newtonis/Assistance-Bracelet/altium/PCB/Electrónica 4 – TP 2 – Grupo 1.pdf

# Instituto Tecnológico de Buenos Aires

## 22.14 - Electrónica IV

# Trabajo práctico N◦2

### Grupo 1

Mechoulam, Alan | 58438
Lambertucci, Guido Enrique | 58009

### Londero Bonaparte, Tomás Guillermo 58150

### Profesores Aguirre, Miguel Pablo Cossutta, Pablo Martín Weill, María Alejandra Salvati, Matías Damián

### Presentado: 22/06/21

22.14 - Electrónica IV | Mechoulam, Lambertucci, Londero

## Índice

1. Parte I | 2
2. Parte II | 2
3. Parte III | 8
4. Parte IV | 15
5. Conclusiones | 18

## 1. Parte I

### 1.1. SG3525A

### 1.1.1. Debajo de la tensión de operación

Este dispositivo cuenta con un pin de control llamado “Shutdown”. Este pin controla tanto el circuito de Soft-Start como las etapas de salida, apagando la salida automáticamente a través de pulsos de shutdown.
Al haber una tensión inferior al mínimo (8 V ) en la entrada, este sistema de shutdown se activa, inhabilitando las salidas y los cambios en el capacitor de Soft-Start.
Esto protege al circuito conectado a la salida de la flyback, asumiendo que es mejor cortar la alimentación que proveer un valor indeterminado de tensión.

### 1.1.2. Señal a la salida

Para seleccionar la frecuencia de la señal a la salida del integrado, se deben conectar dos resistencias y un capacitor en los pines CT y RT . El criterio de selección viene dado por las siguientes limitaciones:

fs =

1
CT (0.7RT + 3RD)

(1)

2.0 kΩ 6 RT 6 150 kΩ
0 Ω 6 RD 6 550 Ω
1 nf 6 CT 6 200 nf

Existe una relación entre la frecuencia del oscilador y la de salida. Sucede que la frecuencia del oscilador es el doble que la frecuencia de salida, dado que en un ciclo acciona una salida y en el siguiente la otra.

Para conseguir una frecuencia de 100 kHz a la salida (∼ 200 kHz en el oscilador), basta con tomar:

RT = 2.2 kΩ
RD = 0 Ω
CT = 3.3 nf

(2)

Para conseguir un Duty deseado, lo que se debe hacer es colocar la salida del amplificador de error a 0 V (pin no inversor a masa y pin inversor a Vref ), luego aplicando una tensión en el pin de compensación (9), es posible manejar el duty de salida.

### 1.1.3. Soft-Start

El pin de Soft-Start cumple con la función de limitar el duty cicle en el arranque, hasta que el capacitor de SS esté cargado. Cuando se está empleando una fuente realimentada se busca que en el arranque no se produzca un duty cycle tal que se llegue a la tensión deseada, sino a una menor hasta que se cargue el capacitor SS. De esta forma se evita que se sobredimensione y se pase del valor que se necesita, disminuyendo así las oscilaciones iniciales.

### 1.1.4. Shutdown

Es posible implementar un circuito limitador de corriente utilizando el pin de Shutdown con una resistencia de shunt y un BJT. Se coloca la resistencia de shunt en el camino de la corriente a sensar y en paralelo a la juntura base emisor del bipolar, y se calcula la resistencia de manera tal que cuando haya una corriente mayor a la permitida, la caída de potencial en la resistencia sea mayor que la tensión necesaria para polarizar la juntura del transistor, el cual en consecuencia coloca una señal alta en el pin de shutdown.

## 2. Parte II

### 2.1. Diseño del sistema

En el sistema que se busca desarrollar, se emplean los siguientes valores para la fuente Flyback:

D = 0.3

L1 = 40 µH

R1 = R3 = 10 Ω

C1 = C3 = 47 µF

C2 = C4 = 2 µF

N1
N2

= 3

N2 = N3

Para el circuito del SG3525 se adoptaron los siguientes valores

RT = 2.2 kΩ

CT = 3.3 nF

RD = 0 Ω

Css = 1 µF

calculando el ripple a la salida se obtiene

0.05 =

∆Vo
Vo

=

DTs
RoC

(3)

C =

DTsVo
RoC∆Vo
= 8.8µF | (4)

por lo que se seleccionó una combinación de capacitores con una capacitancia total de ≈ 48µF siendo el paralelo de 1 capacitor electrolítico,3 cerámicos (2 de 1µF y uno de 68pF). Esta combinación se realiza con la intención de no solo aumentar la capacidad de salida, sino que tambien reducir la ESR neta de salida.
La combinación de valores de RT y CT fueron elegidas para mantener la frecuencia de switching elegida. La resistencia RD es nula para que se descargue lo mas rápido posible. Por último, el capacitor Css es para que tenga un comienzo suave. Para la salida se utilizarón los diodos MUR160 y para el snubber se utilizó el diodo Schottky.
N2 | C1 | C2 | R1
N3 | C3 | C4 | R3

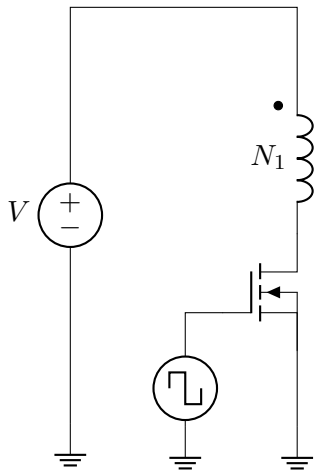
[picture p1: figure]

Figura 1: Circuito del snubber empleado.

### 2.2. Simulaciones

Se simuló el circuito a lazo abierto. De esta forma se obtuvieron las siguientes curvas.

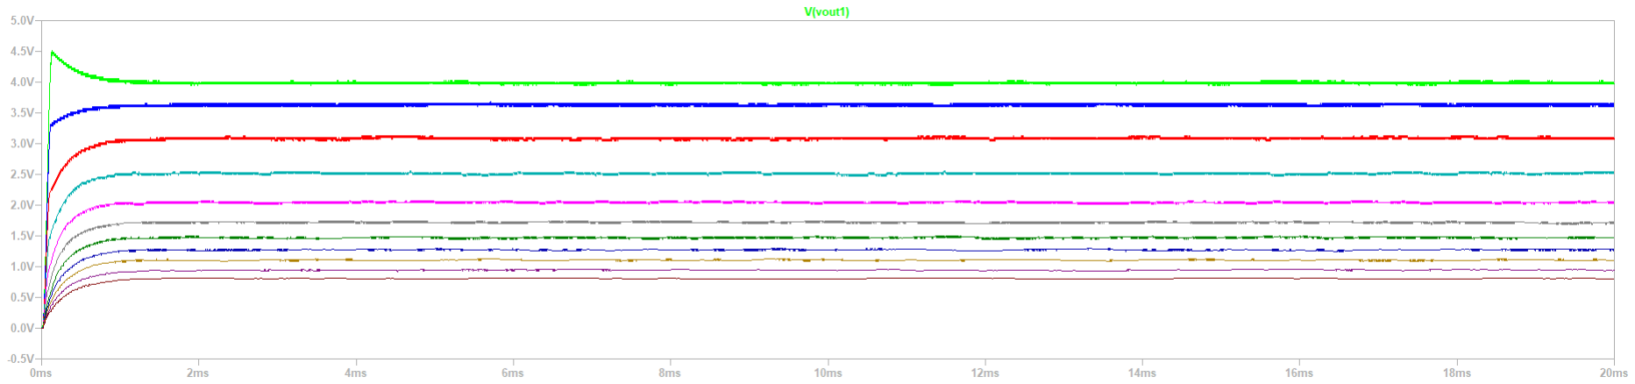
[picture p2: figure]

Figura 2: Variaciones en la Vout al cambiar la Vcomp.

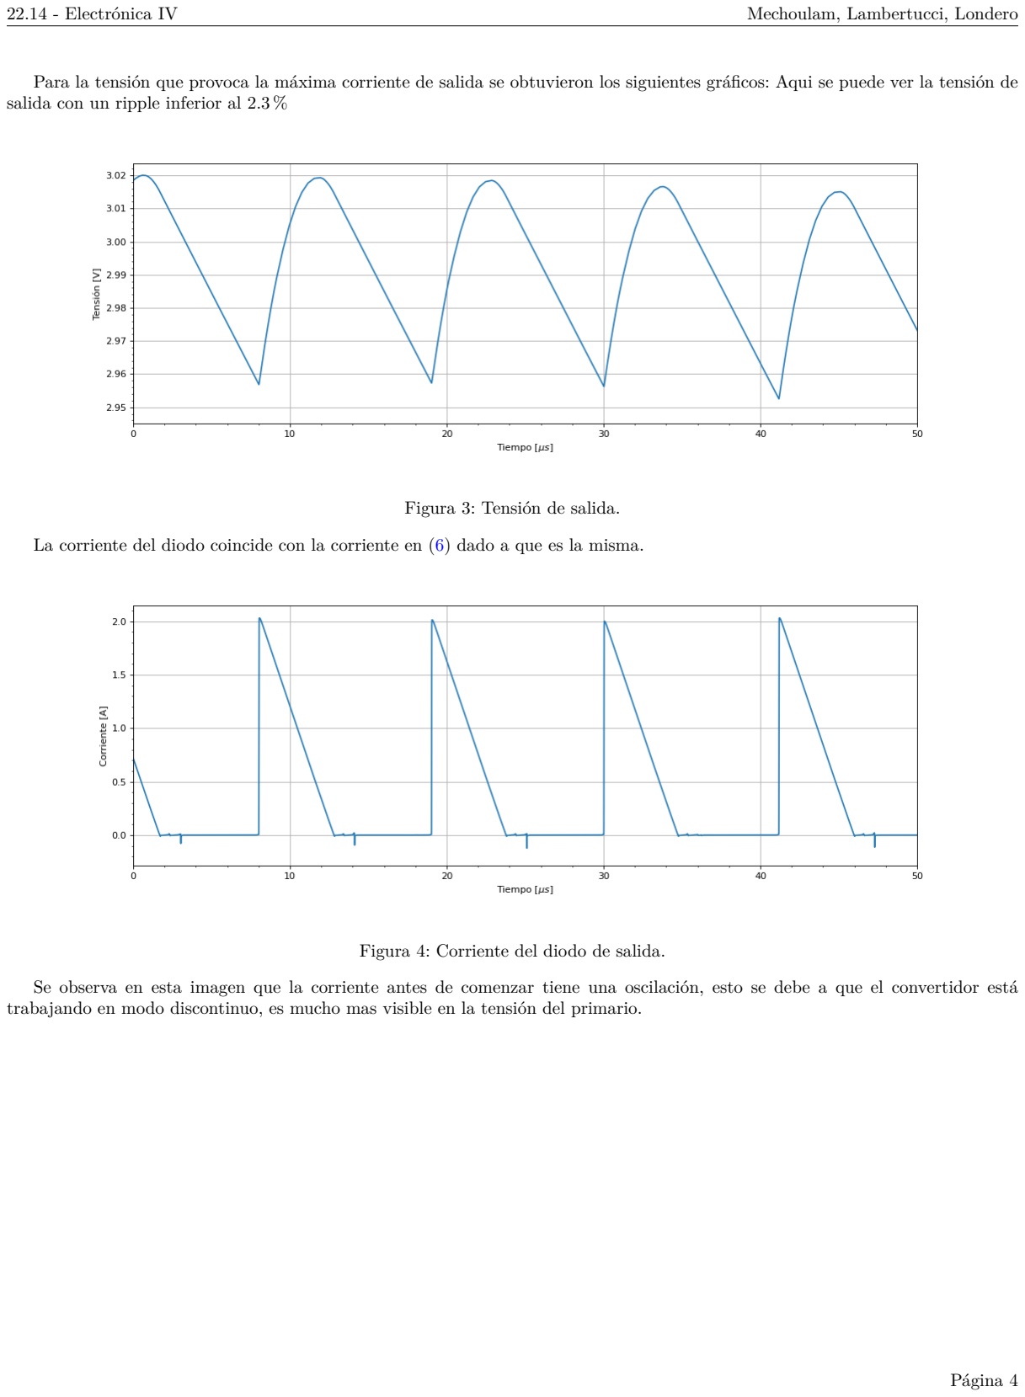
[picture p3: page 5]

Para la tensión que provoca la máxima corriente de salida se obtuvieron los siguientes gráficos: Aqui se puede ver la tensión de salida con un ripple inferior al 2.3 %

Figura 3: Tensión de salida.

La corriente del diodo coincide con la corriente en (6) dado a que es la misma.

Figura 4: Corriente del diodo de salida.

Se observa en esta imagen que la corriente antes de comenzar tiene una oscilación, esto se debe a que el convertidor está trabajando en modo discontinuo, es mucho mas visible en la tensión del primario.

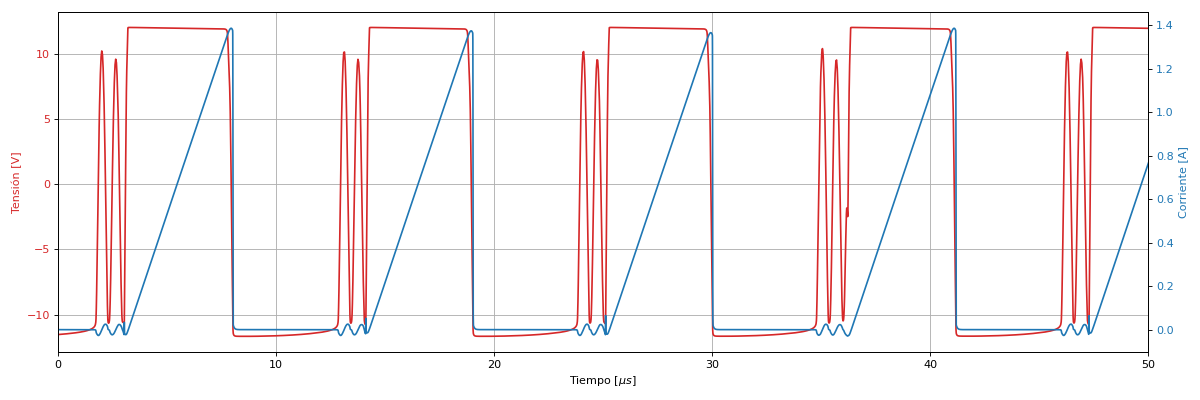
[picture p4: figure]

Figura 5: Tensión y corriente del primario.

Aqui se ve como la oscilación se ve reflejada en el secundario

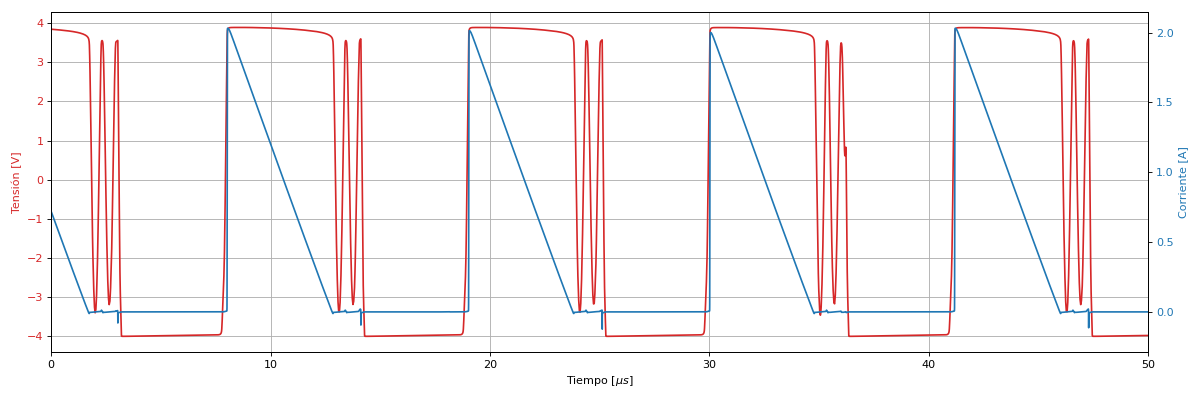
[picture p5: figure]

Figura 6: Tensión y corriente del secundario.

Aqui se ve la tensión de compensación del SG3525.

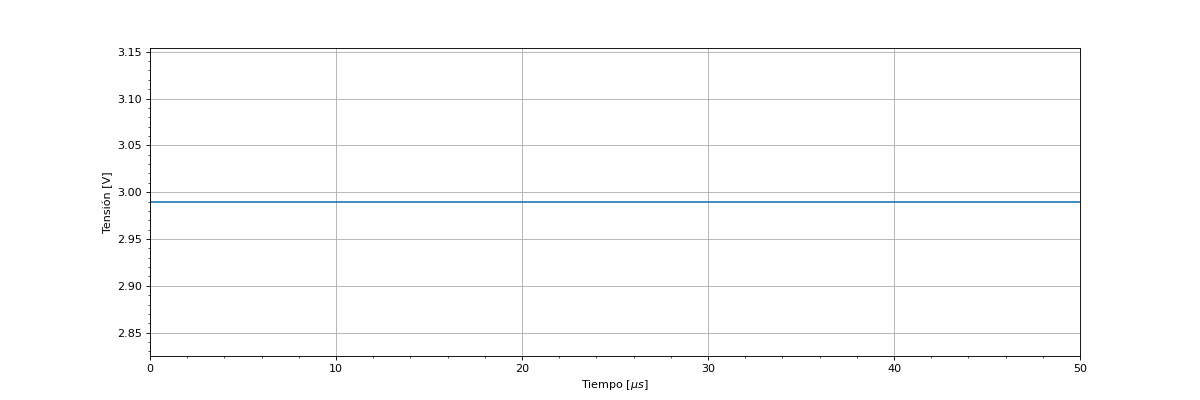
[picture p6: figure]

Figura 7: Tensión de compensación.

En esta imagen se pueden observar varias señales, la verde es la tensión del oscilador del SG3525, la cual cada 2 conmutaciones se traduce a una conmutación en la señal de control del MOS (dado que este cuenta con 2 salidas, en uno actualiza una y en el otro ciclo la otra), por lo que se puede ver como cada 2 pulsos conmuta la Vgs.
Viendo la forma de onda de Vds se aparecia facilmente que el convertidor trabaja en modo discontinuo Idealmente serían 3 niveles de tensión, Vd mas la reflejada, Vd y 0, pero al quedarse sin energía el nucleo, el circuito comienza a oscilar de una manera característica del modo discontinuo.

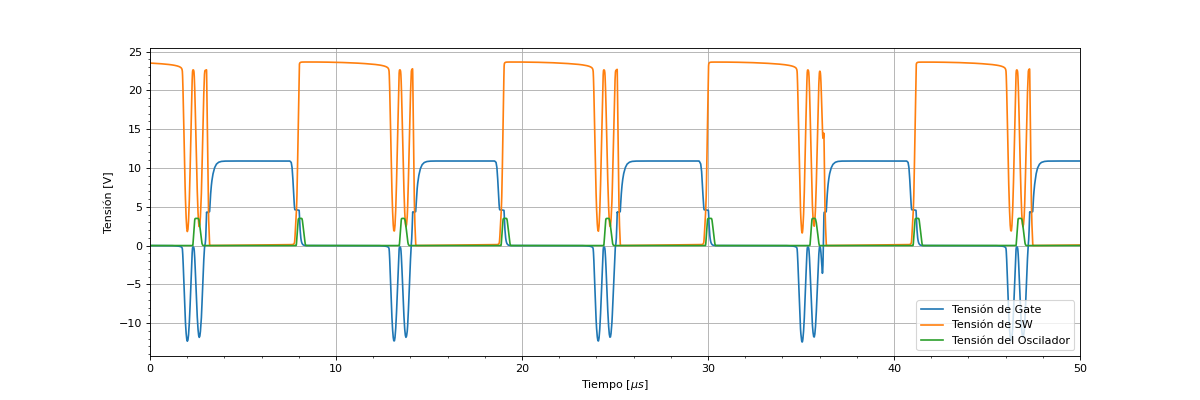
[picture p7: figure]

Figura 8: Tensión de Gate y del Switch.

### 2.3. Snubber

Para el circuito dado, se diseña un snubber empleando un diodo, una resistencia y un capacitor.

Figura 9: Circuito del snubber empleado.

Se calcula el valor máximo del capacitor, planteando que la energía entregada por la inductancia de dispersión debe ser absorbida completamente por el capacitor del snubber. De esta forma, se llega a la expresión:

C > Ld

IL1

2

VC

2 −

VCC − Vo

N1
N2

2 = 1 µH ·

15 A
100 V

2 − (12 V − 3 · 0.8 V )

2 = 23 nF | (5)

De esta forma, se selecciona C = 35 nF. Planteando que tres veces el tiempo característico del sistema RC debe ser menor al tiempo en que el transistor se encuentra encendido, para así descargar completamente al capacitor, se obtiene una restricción similar para la resistencia. Operando, se llega a:

R < DTS
3C
C=10 nF

=

0.3
100 kHz ·

1
3 · 35 nF
= 29 Ω | (6)

Finalmente se selecciona R = 47 Ω.
Para el diodo del snubber se utilizó el diodo schottky 1N5819

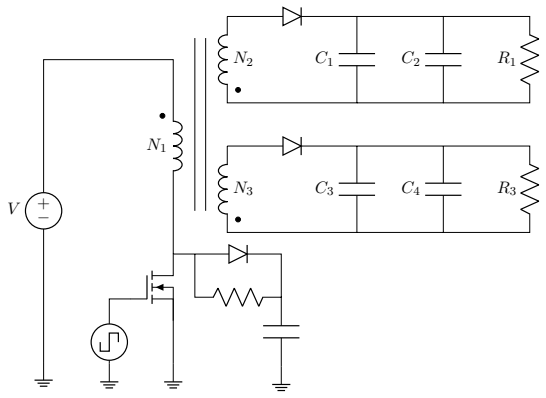
[picture p8: figure]

Figura 10: Circuito Flyback con snubber.

Se simuló el circuito con la integración del snubber y se observa como las oscilaciones provocadas por el modo discontinuo fueron severamente reducidas.

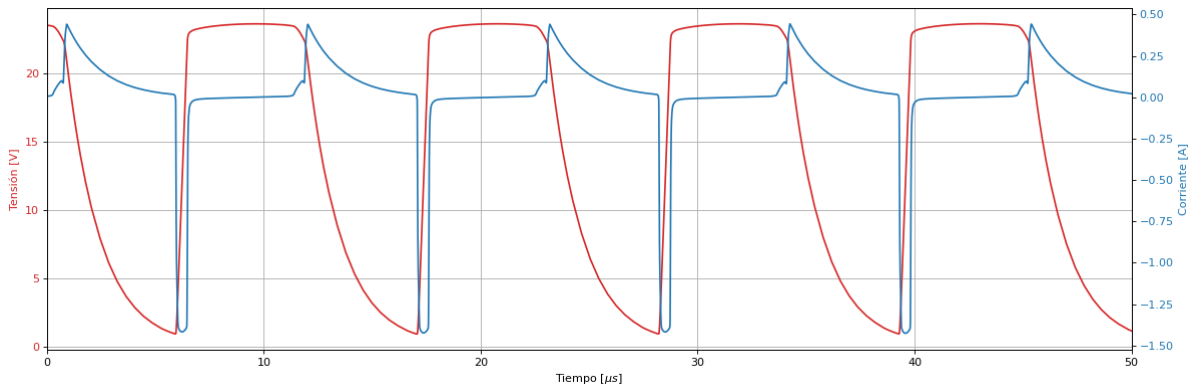
[picture p9: figure]

Figura 11: Tensión y corriente en el capacitor de snubber.

Aqui se observa las formas de onda de tensión y corriente sobre el capacitor del snubber una vez que fue agregado a la simulación. donde se observa que la tensión del capacitor llega a un valor máximo de Vc ≈ 25V y no se descarga del todo sino que llega a unos 2.5V.

### 2.4. Potencias

Las potencias teóricas calculadas son:

PMOS =

fsw
2
- VswIN1−mintsw2 =

88 kHz
2
- (21 V ) · (400 mA) · (300 ns) = 110 mW

PRSnubber =

CVC

2Fsw
2 = 679 mW

Pdiodo = (IoR²

d + IoVD)D = 444.44mA(0.038Ω)² + 444.44mA1.25V 0.3 + PIrr = 167.31mW

despreciando la corriente de reverse recovery y utilizando datos del MUR160. Las medidas en la simulación son:

PMOS = 45 mW

PRSnubber = 388.6 mW

Pdiodo = 258.35 mW

Donde para el diodo se utilizó un MUR460.

### 2.5. Eficiencia

Se calculó la eficiencia del circuito de la siguiente manera:

η =

PLoad
Pd

=

2 · V

2
o /RL

2 · V ²
o /RL +

CV ²
C Fsw
2 +

fsw
2
- Vsw
Vo/RL
1−D

·

N2
N1

−

Vo
2L2·fsw
- (1 − D)

N1
N2

tsw2

Vo=3V & RL=6.25Ω

= 70.35 % (7)

Para el gráfico se tomó una resistencia mínima de 0.71 Ω dado que con este valor satura el transformador y una máxima de 50Ω.

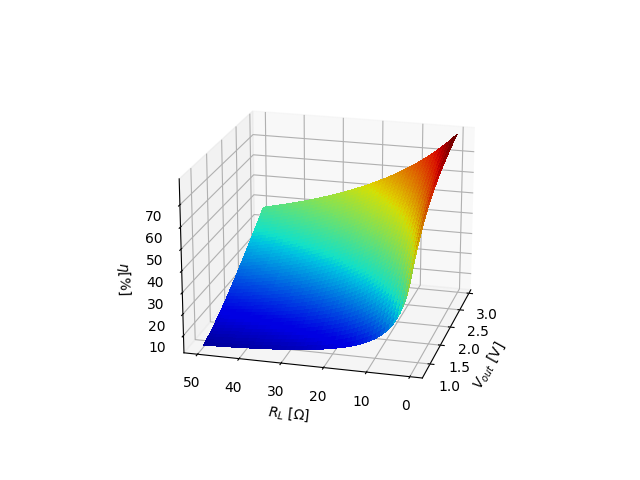
[picture p10: figure]

Figura 12: Eficiencia en función de la carga y tensión.

Se observa que la combinación que da la mayor eficiencia tiende mientras que la simulada corresponde a baja carga y alta tensión.
Luego se obtuvo la eficiencia en la simulación.
η = 73 % | (8)

## 3. Parte III

### 3.1. Matrices de estado

Para obtener teóricamente la transferencia del circuito, se vale del método de variables de estado. De esta forma, se llega a las siguientes matrices:

A =

−

DR1
L1

+

(1−D)n

2RC R
(R−RC )L1

(1−D)nR
(R−RC )L1
−

(1−D)nR
(R−RC )C | −

D
(R−RC )C −

(1−D)
(R−RC )C

!
(9)

B =

−
| D
| L1

0

0 0
(10)

C =

−

(1−D)nRRC
R−RC

DR
R+RC

+

(1−D)R
R−RC
(11)

D =

0 0
(12)

Se toman los valores seleccionados en la Sección (2). Además se consideran las resistencias tanto de N1 y de los capacitores de salida (para las cuentas se consideran los dos capacitores en paralelo como uno solo con una única ESR) siendo estos RL = 0.001 Ω y RC = 0.001 Ω respectivamente. De esta forma se obtiene la transferencia del sistema:

G(s) = C (sI − A)

−1
B =

−15.75s + 3.351 · 10⁸
s

2 + 3002s + 2.346 · 10⁹

(13)

### 3.2. Compensador

Se utiliza el siguiente circuito como compensador:

−

+

Ve

Vref

Rf1

Vout

Rf2

RC1

CC1

CC2

Figura 13: Circuito compensador del sistema.

La transferencia de este sistema es la siguiente:

H(s) = 1
Rf1CC2

·

s +

1
RC1CC1
s
s +

RC1+RC2
RC1CC1CC2
| (14)

Se emplean los siguientes valores:

RC1 = 10 kΩ

Rf1 = Rf2 = 1 kΩ

CC1 = 10 nf

CC2 = 1 µf

N2 = 1 µH

Con esos valores, el compensador queda: H(s) = 0.0001s + 1
1 · 10−7s
2 + 0.00101s

(15)

De esta forma, la ganancia de lazo queda de la forma:

T(s) = G(s) · H(s) = −0.001575s

2 + 3.35 · 10⁴

s + 3.351 · 10⁸
1 · 10−7s
4 + 0.00131s

3 + 237.6s

2 + 2.369 · 10⁶s

(16)

Con el sistema realimentado, se grafican los diagramas de Bode para la transferencia y para la ganancia de lazo T, algiual que el diagrama de polos y ceros del sistema.

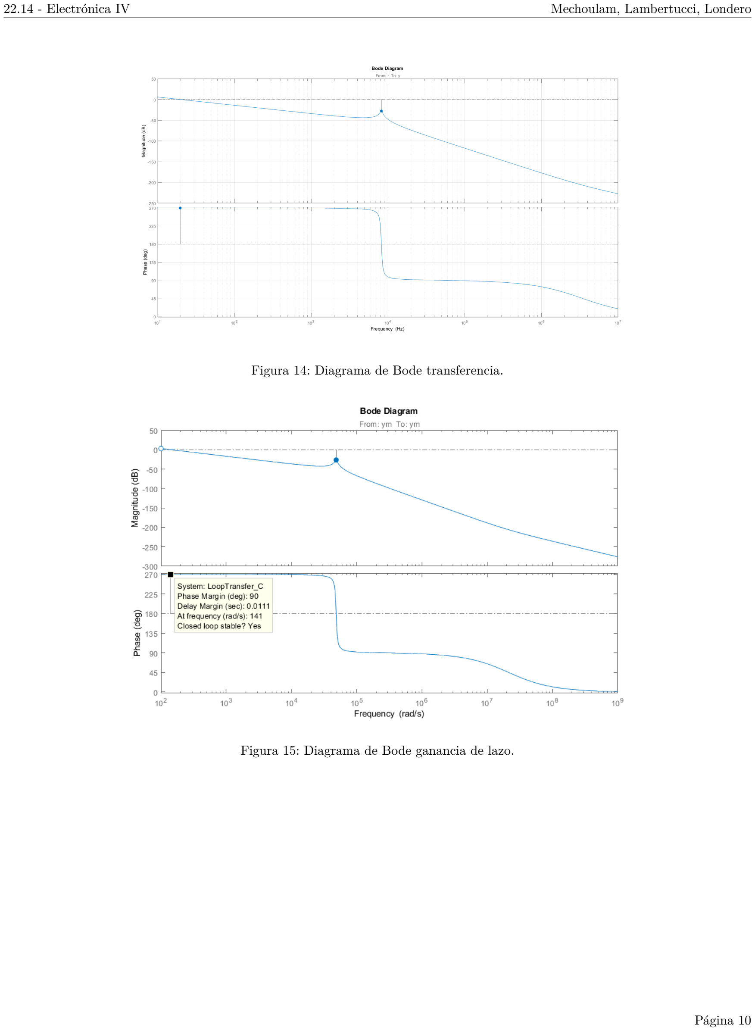
[picture p11: page 11]

Figura 14: Diagrama de Bode transferencia.

Figura 15: Diagrama de Bode ganancia de lazo.

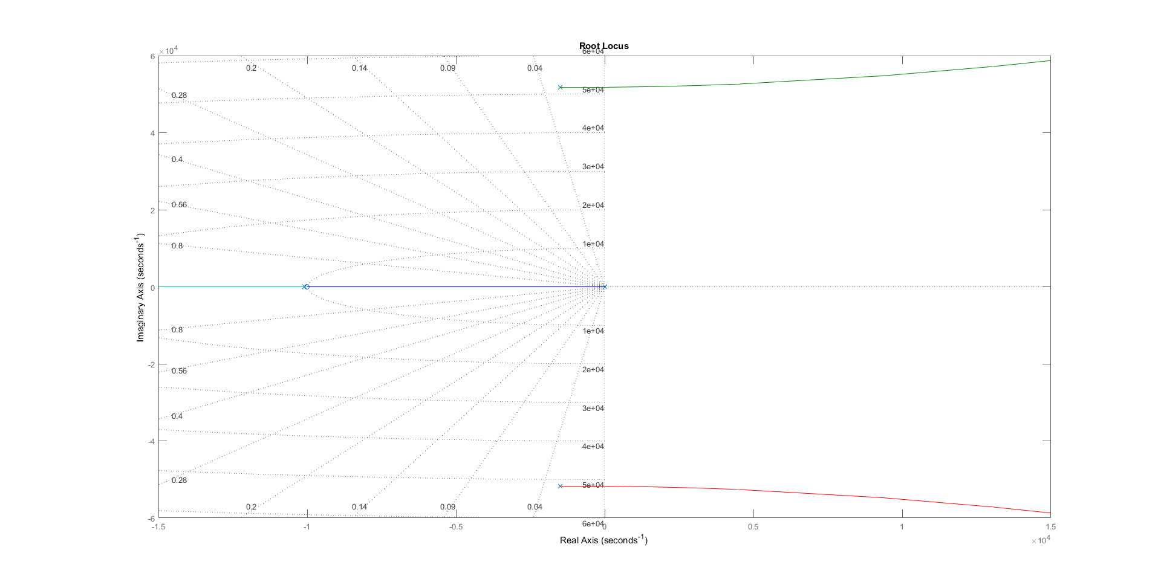
[picture p12: figure]

Figura 16: Plano S, diagrama de polos y ceros.

Una particualridad de la topología Flyback es la existencia de un cero en el semiplano derecho. En lineas generales, si

|T| >> 1 =⇒

Vo

Vref

≈

1
β
= 2 =⇒ Vo ≈ 2 · Vref | (17)

En el diseño del realimentador se tuvieron en cuenta diversos lugares para colocar una resistencia variable. Esta podría ser en Rf1, Rf2 o simplemente se podría variar la Vref .
El problema que se encontró con poner la variable en Rf2 es que la variación de salida con esta resistencia resulta homográfica, siendo preferible que sea lineal. Es por ello que esta opción quedó descartada. Finalmente se optó por variar únicamente la tension de Vref .
Debido a que los potenciómetros cuentan con una inductancia parásita considerable y, dado que este es el realimentador, se podrían introducir polos ó ceros indeseados al sistema empleando dicho componente.

### 3.3. Simulaciones

Finalmente se realizó la simulación a lazo cerrado y se obtuvieron las siguientes curvas:

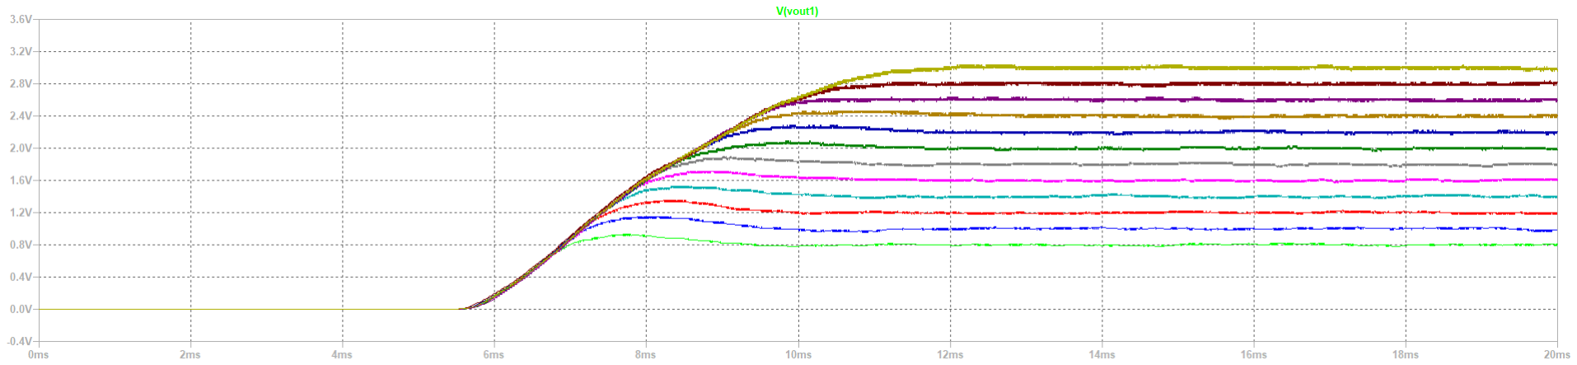
[picture p13: figure]

Figura 17: Variación de tensión de salida.

Al igual se midieron todas las curvas relevantes del sistema: En el caso de la tensión de salida, se observa un ripple del 2 %.

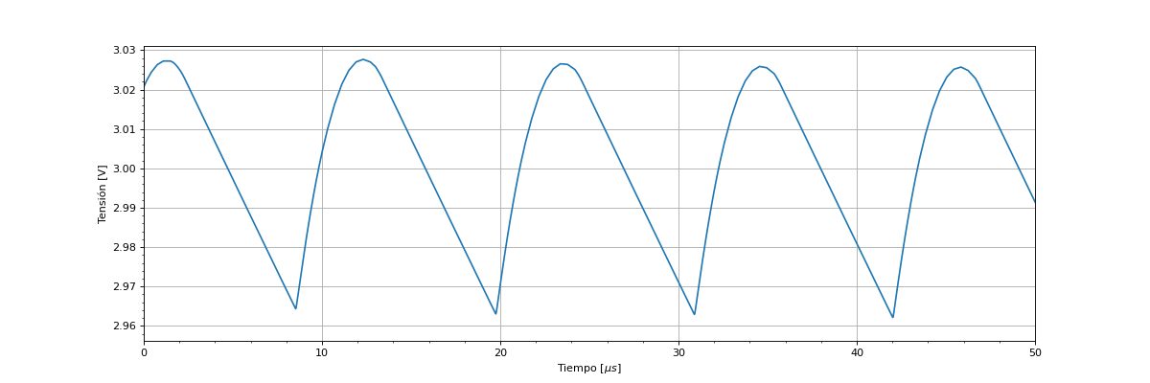
[picture p14: figure]

Figura 18: Tensión de salida.

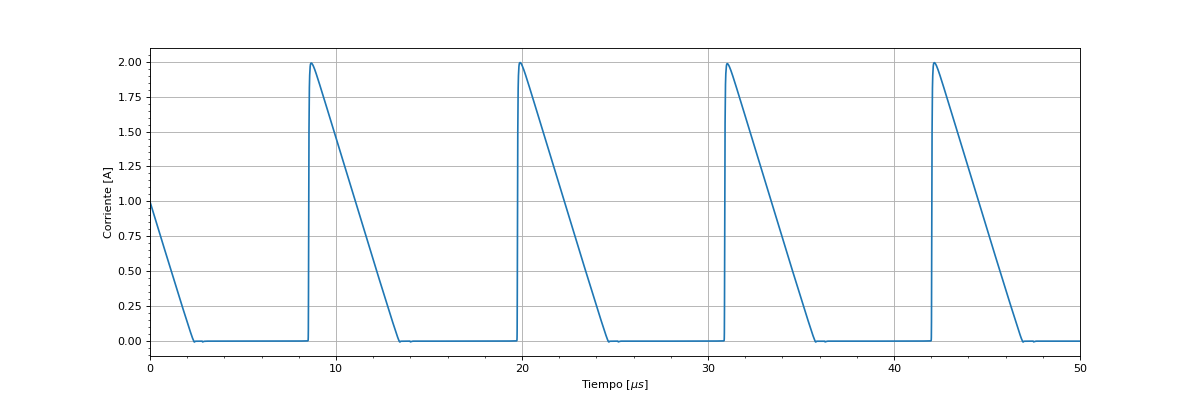
[picture p15: figure]

Figura 19: Corriente del diodo.

Se puede observar en esta simulación y todas las siguientes, que se produce una pequeña oscilación proveniente del nodo de switching, la cual se propaga al resto del circuito mediante la relación de transformación. El origen de estas oscilaciones se debe a la pérdida de energía total en el campo magnético del transformador la cual antes provocaba que se polarice el diodo del secundario en directa. Al acabarse la energía del núcleo y polarizándose débilmente al diodo en inversa, circula la corriente de reverse recovery del diodo por el secundario, inyectándose por la relación de transformación al primario, y finalmente produciendo oscilaciones entre la inductancia del primario y la capacitancia de salida del transistor.

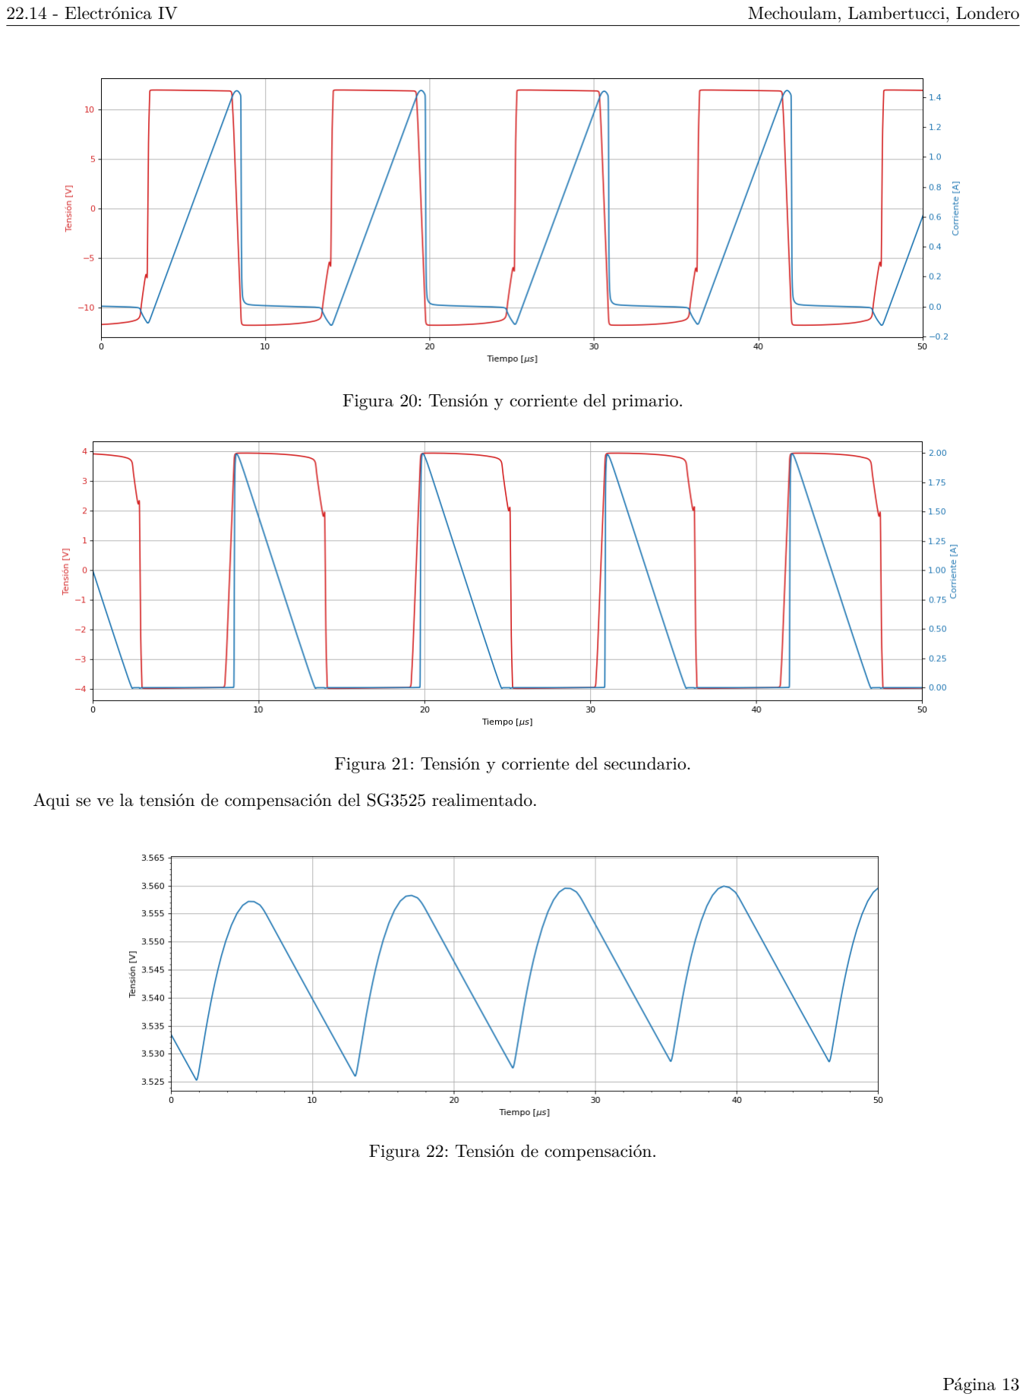
[picture p16: page 14]

Figura 20: Tensión y corriente del primario.

Figura 21: Tensión y corriente del secundario.

Aqui se ve la tensión de compensación del SG3525 realimentado.

Figura 22: Tensión de compensación.

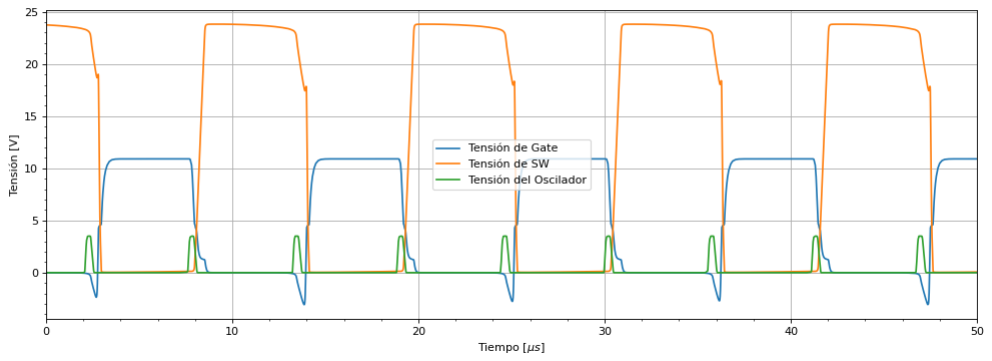
[picture p17: figure]

Figura 23: Tensión de Gate y del Switch.

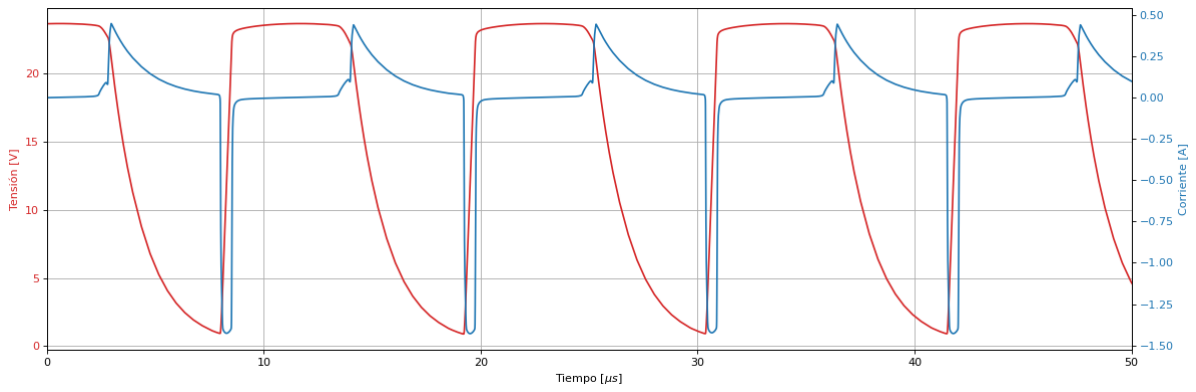
[picture p18: figure]

Figura 24: Tensión y corriente en el capacitor de snubber.

También se colocó en la simulación varios capacitores en paralelo con varias ESR distintas (10mΩ ∼ 1Ω). Se observa el efecto característico de la ESR sobre la tensión de salida provocando ”saltos” de tensión sobre la misma como se ve a continuación.

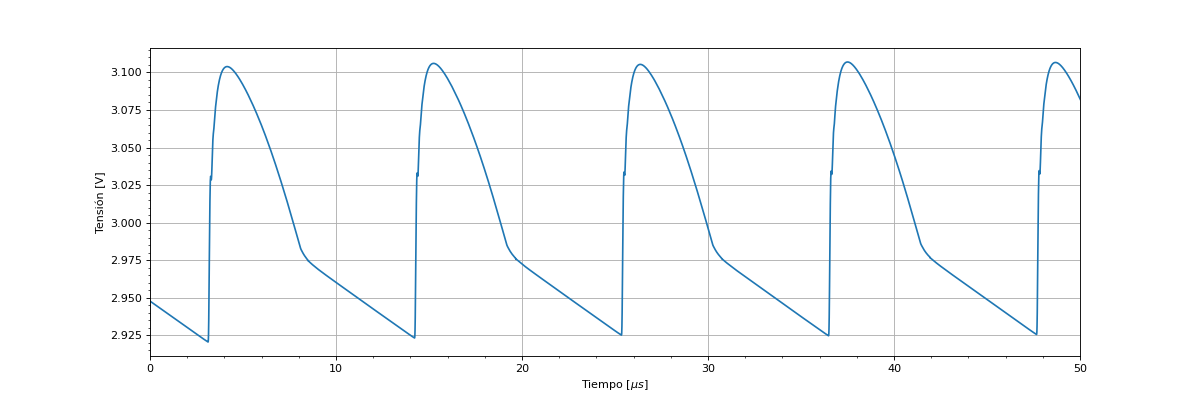
[picture p19: figure]

Figura 25: Tensión de salida con ESR.

Esto se puede subsanar al agregar aun mas capacitores en paralelo que reduzcan la ESR.
Finalmente vale la pena mencionar la desaparición casi completa de las grandes oscilaciones que se observaban en la sección anterior, esto se debe a la introducción del circuito de snubber.

## 4. Parte IV

### 4.1. Diseño de placa

Se diseño la placa en multiperforada, teniendo la posibilidad de medir la tensión en los pines de compensación, drain, gate, primario, secundario y en el pin no inversor. Tambíen es posible cambiar la carga del circuito, y la tensión de salida.
Se colocaron a la salida varios capacitores en paralelo, teniendo distintas tecnologías (electrolíticos, cerámicos) para bajar la ESR, al igual que para subir la capacidad de salida.
El sistema, si bien fue diseñado en modo continuo, trabaja en modo discontinuo debido a la baja corriente de salida que es pedida por la carga. Aún si se quisiese, no podría trabajar en modo continuo debido a que la corriente necesaria para que este trabaje en modo continua resultaría en la saturación del transformador lo cual no es deseable.

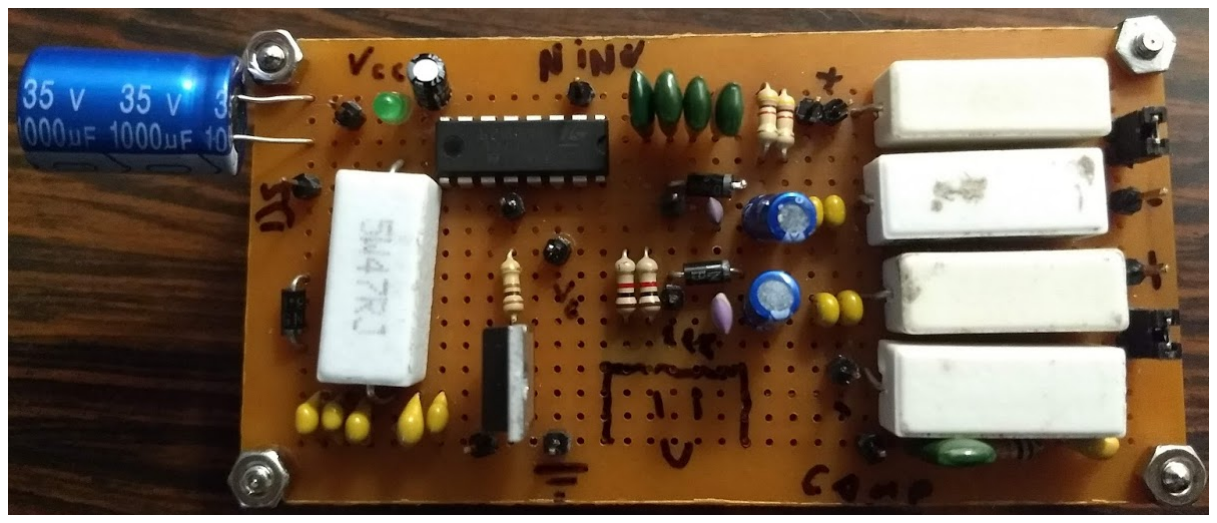
[picture p20: figure]

Figura 26: Tensión de compensación.

### 4.2. Mediciones

Lo primero que vemos en la tensión de compensación que a diferencia de (22) este cuenta con un valor menor debido a que se tiene una Vref distinta para obtener la salida deseada.

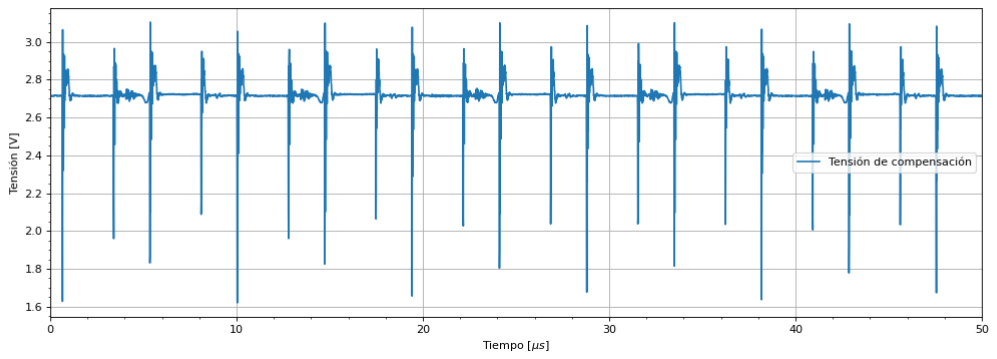
[picture p21: figure]

Figura 27: Tensión de compensación.

Se puede observar que la tensión en el capacitor de snubber efectivamente no se llega a descargar por completo debido a la selección de la resistencia de snubber limitado a la disponibilidad de componentes.

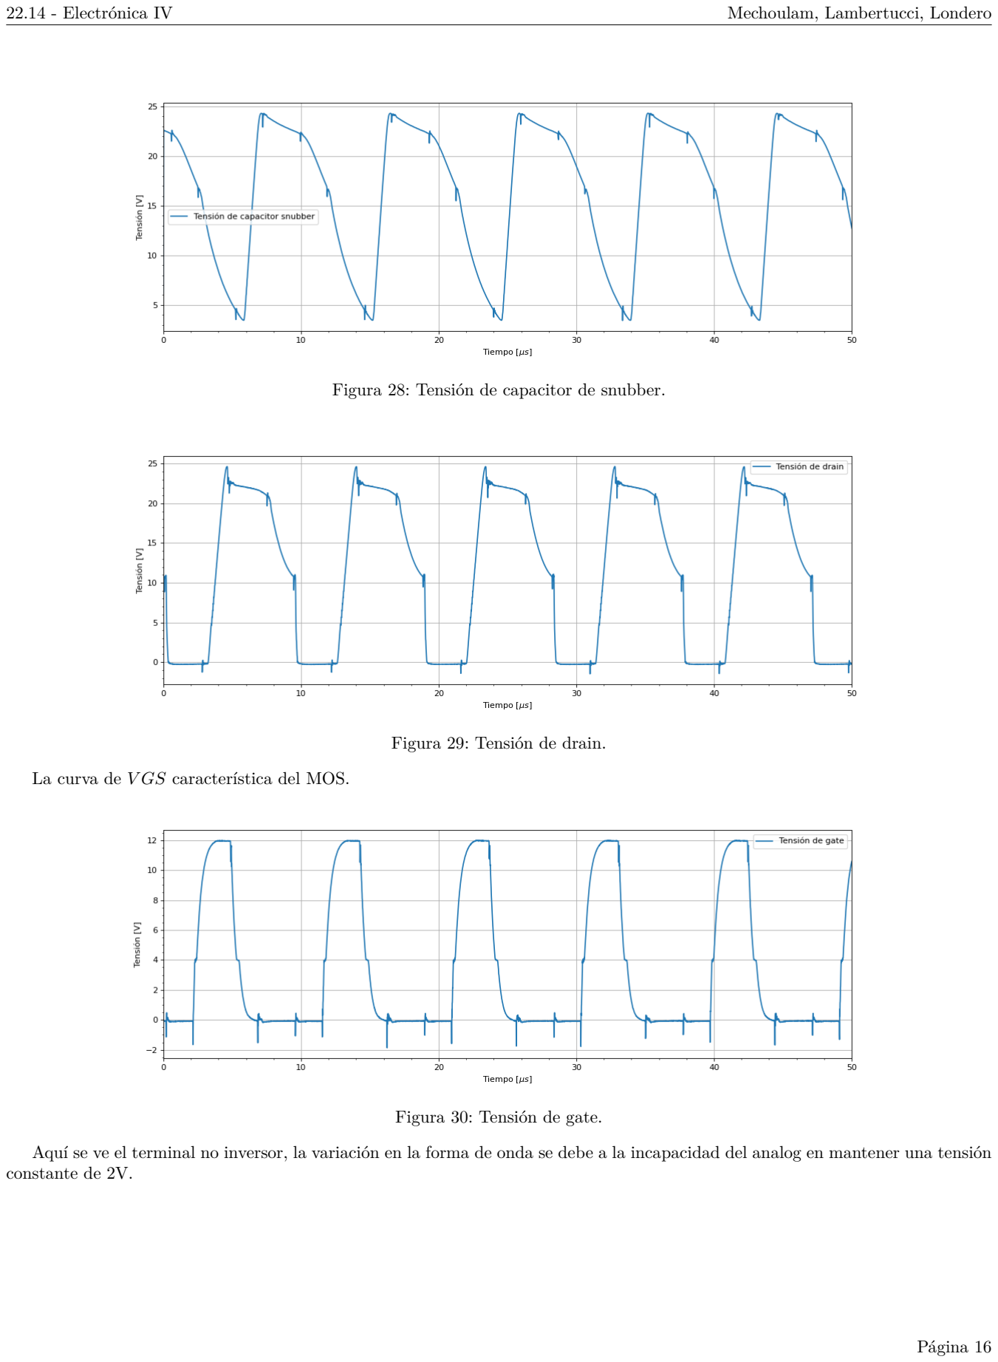
[picture p22: page 17]

Figura 28: Tensión de capacitor de snubber.

Figura 29: Tensión de drain.

La curva de V GS característica del MOS.

Figura 30: Tensión de gate.

Aquí se ve el terminal no inversor, la variación en la forma de onda se debe a la incapacidad del analog en mantener una tensión constante de 2V.

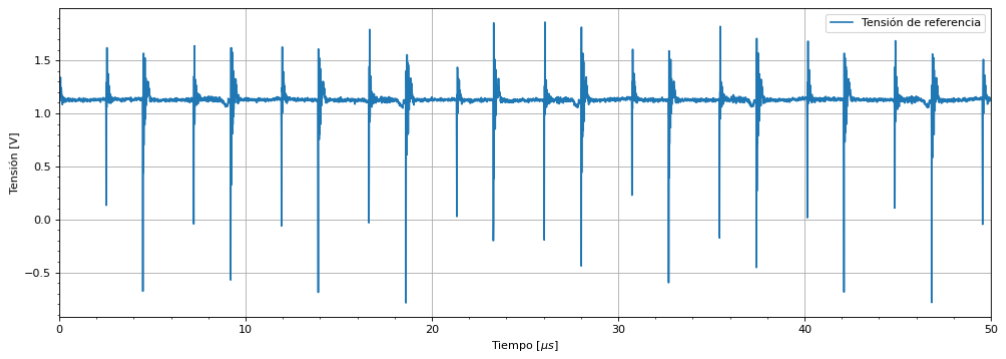
[picture p23: figure]

Figura 31: Tensión no inversora.

En la siguiente figura se ve la tensión de salida,en la primera figura se observa que no cumple el rango pedido, esto se debe a la ESR de los capacitores.

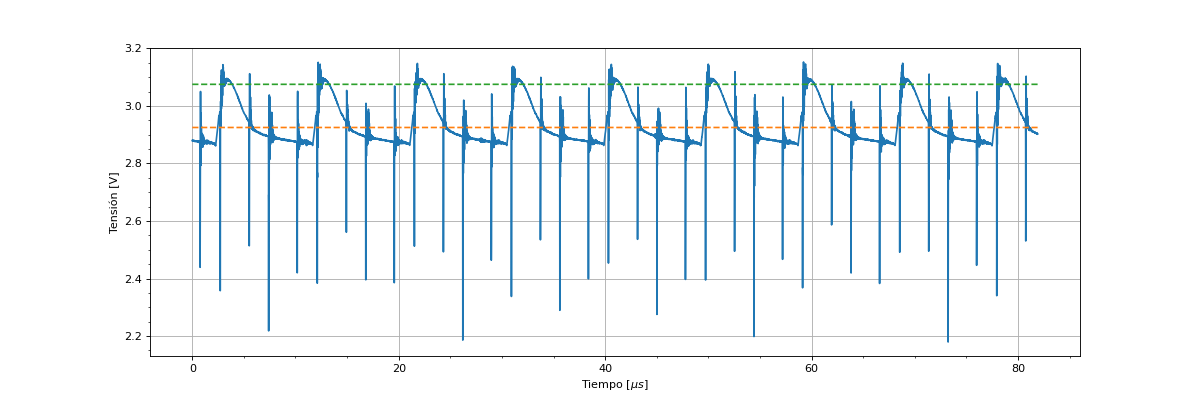
[picture p24: figure]

Figura 32: Tensión de salida con pocos capacitores.

Luego se agregó capacitores en paralelo para mitigar el efecto de la ESR. Finalmente se observa que la salida se mantiene en el rango de tensiones permitido, teniendo un ripple de salida de aproximadamente el 4 %. Aunque tiene unos picos de alta frecuencia que se dan en 4 ocaciones especificas que van a a ser explicadas luego.

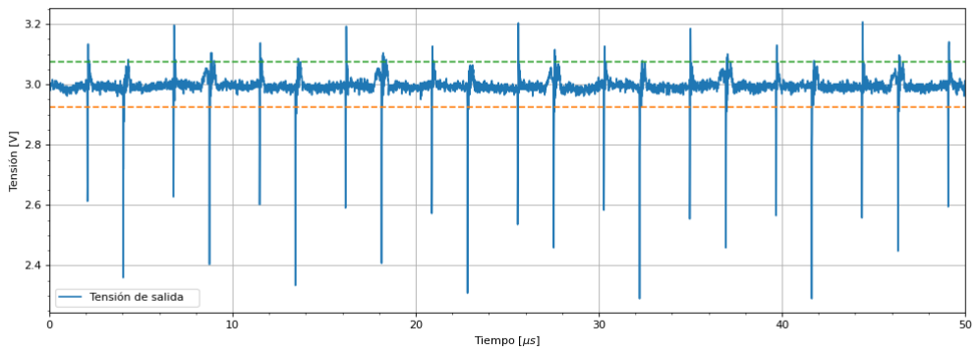
[picture p25: figure]

Figura 33: Tensión de salida.

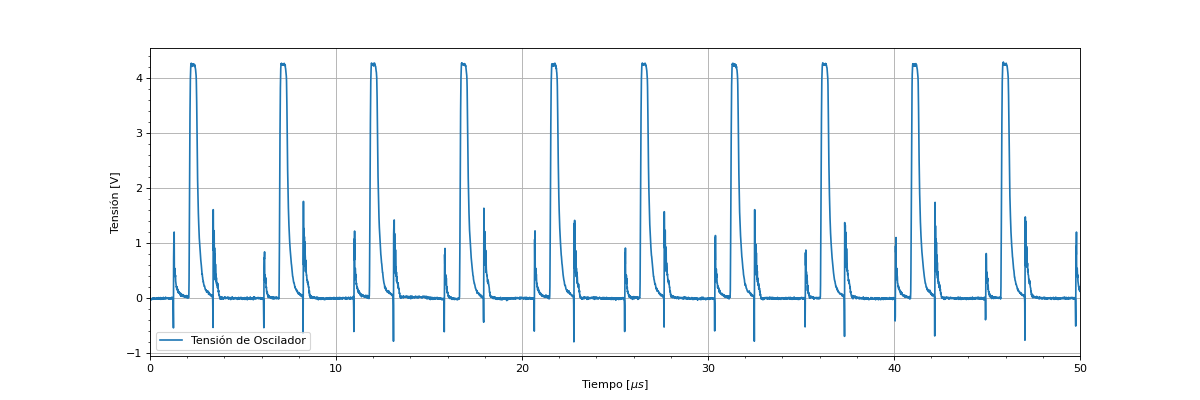
[picture p26: figure]

Figura 34: Tensión de oscilador.

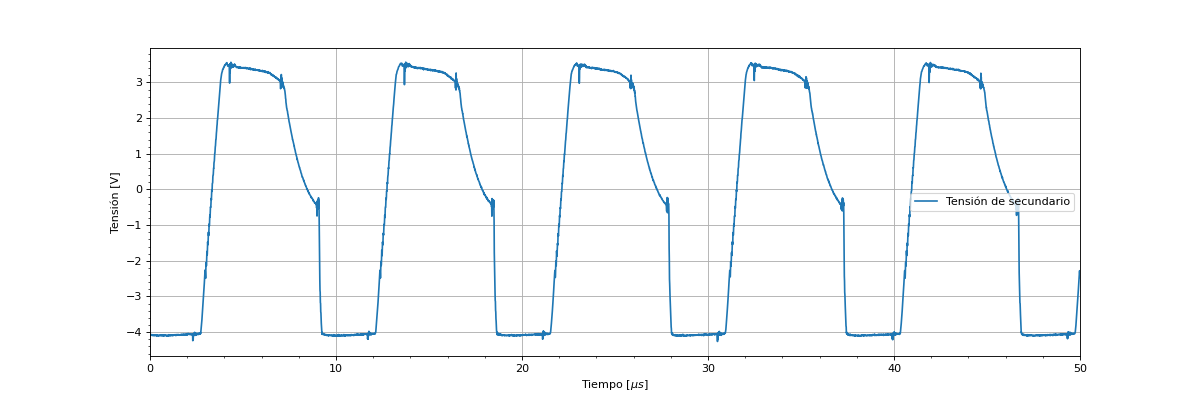
[picture p27: figure]

Figura 35: Tensión de secundario.

Se pueden observar cuatro oscilaciones distintivas en las mediciones de la mayoría de las tensiones del circuito, estas suceden al momento de apagar la llave, debido a los efectos de la Ld, inmediatamente después de apagar la llave provocado por el sobrepico del diodo de potencia. Al quedarse sin energía el núcleo del transformador por las mismas razones explicadas anteriormente. Y finalmente al encender la llave, aqui suceden 2 cosas el capacitor del snubber se descarga sobre el MOS al igual que se comienza a cargar la inductancia del primario.

## 5. Conclusiones

Se obtuvo conocimiento del funcionamiento del IC SG3525, tanto de su funcionamiento interno como de sus funcionalidades. Además, se obtuvieron conocimientos prácticos en el armado de un circuito que permite variar tanto la frecuencia como el duty del generador de pulsos.
Se pudo simular en LTSpice el circuito y se calculó un snubber para este, midiendo su eficiencia (variando tanto carga como tensión de salida) y comparando tanto los valores teóricos con simulados. También se modeló la función transferencia de la fuente Flyback mediante el uso de la promediación de variables de estados. Obteniendo la función transferencia, una particularidad de la topología Flyback es la existencia de un cero en el semiplano derecho. Lo cual trae el problema de que este cero querrá traer los polos al semiplano derecho, asi provocando inestabilidad.
Para asegurar estabilidad se diseño un compensador para ubicar los polos en un sector que asegure estabilidad del sistema, asi cerrando el lazo de realimentación en una configuración no inversora. Obteniendo la ganancia de lazo, se obtuvo su diagrama de Bode de alli el margen de fase, que es un valor clave al analizar la estabilidad del sistema. al igual que el diagrama de polos y ceros. Finalmente se implemento en una placa multiperforada teniendo en cuenta los lineamientos para el diseño de circuitos de potencia provistos por la cátedra. Agregando un capacitor en la entrada. al igual que múltiples capacitores en la carga para auementar la capacidad y bajar la ESR equivalente. Haciendo pistas únicamente de cables y no de estaño.
En resumen realizó el diseño de un convertidor DC-DC topología Flyback realimentado exitosamente, con 2 salidas simétricas y la posibilidad de variar la tensión entre un rango de 0.8 V a 3 V , con una tensión de referencia (la cual podría ser reemplazada por un potenciómetro conectado entre la tensión de referencia del SG3525, el pin no inversor y masa). Se vió el efecto de la ESR sobre la salida y como mitigarlo. Además se observó el comportamiento de la fuente al variar los valores de carga.
