newtonis/Assistance-Bracelet/app/src/assets/reloj-inteligente.png

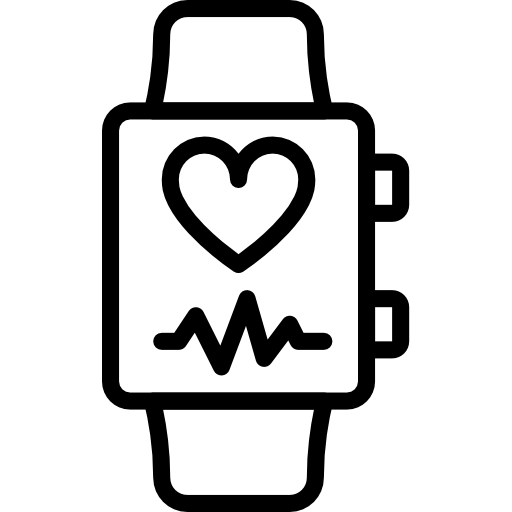
app/src/assets/reloj-inteligente.png
