newtonis/Assistance-Bracelet/(list of files, drawings)

Other design files:
altium/PCB/MOD_ALIMENTACION.SchDoc
altium/PCB/MOD_BOTONES.SchDoc
altium/PCB/MOD_ILUMINACION.SchDoc
altium/PCB/MOD_SONIDO.SchDoc
altium/PCB/MOD_VIBRACION.SchDoc
altium/PCB/PCB1.PcbDoc
altium/PCB/PCB_Project4.PrjPCB
altium/PCB/PULSERA.SchDoc
altium/PCB/Sheet1.SchDoc
altium/PCB/WEMOS D1 MINI_2021-04-02.schdoc
